chad-cros-tamu/AutomatedSafetySystem/README

The hardware folder folder is for the hardware designs of the main controller board, the light curtain and the proximity sensor
The firmware folder is for the code that runs the MCU.
