chad-cros-tamu/AutomatedSafetySystem/webpage/README.md

# Team-11-Senior-Design
ECEN 403-Team 11 Senior Design Repository (Spring 2019)
