chad-cros-tamu/AutomatedSafetySystem/Hardware/Light Curtain Board Design/README

Design and validation of light curtain sensor
