chad-cros-tamu/AutomatedSafetySystem/Hardware/Light Curtain Board Design/reference voltage.xlsx

Reference Voltage | 0.7
Distance (in) | Voltage
10 | 4.9
20 | 4.9
30 | 4.9
40 | 4.9
50 | 4.9
60 | 4.9
70 | 4.4
80 | 2.5
Reference Voltage | 1
Distance (in) | Voltage
10 | 4.8
20 | 4.8
30 | 4.8
40 | 1.8
50 | 1
60 | 0.6
70 | 0.3
80 | 0.2
Reference Voltage | 1.5
Distance (in) | Voltage
10 | 4.9
20 | 4.9
30 | 0.2
40 | 0.2
50 | 0.2
60 | 0.2
70 | 0.2
80 | 0.2
Reference Voltage | 0.5
Distance (in) | Voltage
10 | 4.9
20 | 4.9
30 | 4.9
40 | 4.9
50 | 4.9
60 | 4.9
70 | 4.9
80 | 4.9
120 | 4.9
