chad-cros-tamu/AutomatedSafetySystem/Jaime_Weekly_Updates.md

# Week of 09/02
## Accomplished this week:
- Retested the code to make sure that it is functioning
- Found that text messaging part was not working as intended

## Objectives for next week:
- Troubleshoot text messaging notification part of code as it only sends message periodically, not event driven
- Work on first presentation update with the rest of the team

# Week of 09/09
## Accomplished this week:
- Still working on fixing the text messaging issue

## Objectives for next week:
- Fix the text messaging issue 100%
- Have website running from a raspberry pi
