chad-cros-tamu/AutomatedSafetySystem/Hardware/Light Curtain Board Design/logic.asc

A1: or
D1: LED
R1: res; 100
ref: voltage; .800
Sensors: voltage; 1.5
U1: LT1017
U2: LT1017
U3: LT1017
U4: LT1017
U5: LT1017
VCC: voltage; 5
Named nets: 0, V_out, Comp_out, ref
;op Sensors 0.3 4 .1
.dc Sensors 0.3 3.6 .01
