chad-cros-tamu/AutomatedSafetySystem/Hardware/Beacon/Beacon.brd

## EAGLE design Hardware/Beacon/Beacon.brd (2019-11-26)

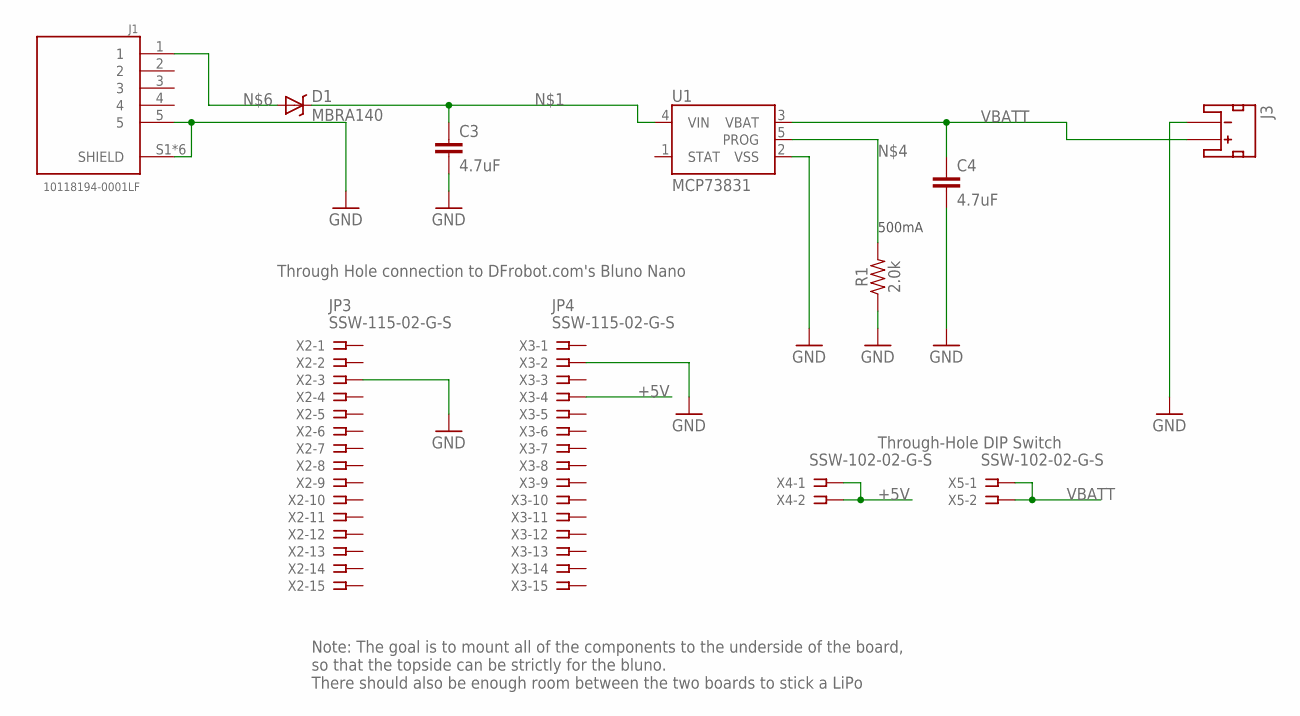
[picture p1: schematic Beacon.sch]

Parts:
C3, C4: 4.7uF; 0603
D1: MBRA140; SMA-DIODE
J1: 10118194-0001LF; AMPHENOL_10118194-0001LF
J3: JST_2MM_MALE; JST-2-SMD
R1: 2.0k; 0603
U1: MCP73831; SOT23-5
X2, X3: SSW-115-02-G-S
X4, X5: SSW-102-02-G-S

Connections:
+5V: X3.4, X4.1, X4.2
GND: C3.2, C4.2, J1.5, J1.S1 (SHIELD), J1.S2 (SHIELD), J1.S3 (SHIELD), J1.S4 (SHIELD), J1.S5 (SHIELD), J1.S6 (SHIELD), J3.1 (-), R1.1, U1.2 (VSS), X2.3, X3.2
unnamed: C3.1, D1.C, U1.4 (VIN)
unnamed: R1.2, U1.5 (PROG)
unnamed: D1.A, J1.1
VBATT: C4.1, J3.2 (+), U1.3 (VBAT), X5.1, X5.2

Notes on the sheet:
500mA
JP3
JP4
Through-Hole DIP Switch
Through Hole connection to DFrobot.com's Bluno Nano
Note: The goal is to mount all of the components to the underside of the board, so that the topside can be strictly for the bluno. There should also be enough room between the two boards to stick a LiPo

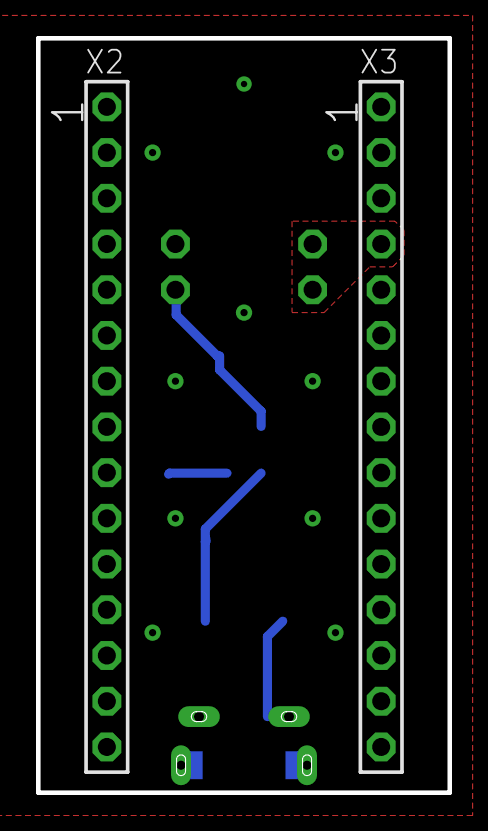
[picture p2: board Beacon.brd from above]

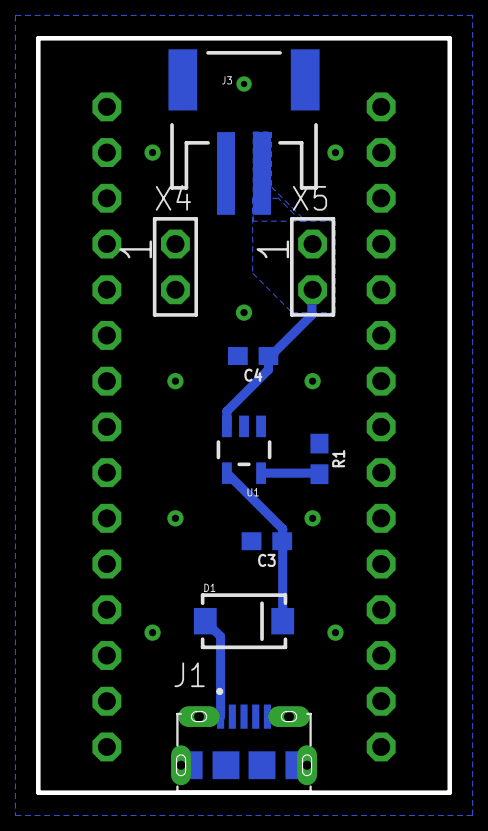
[picture p3: board Beacon.brd from below]

Board: 2 copper layers, 22.9 x 41.9 mm, 11 parts (9 on the bottom side), 6 nets.
