chad-cros-tamu/AutomatedSafetySystem/Hardware/CC3200 Breakout/Breakout.brd

## EAGLE design Hardware/CC3200 Breakout/Breakout.brd (2019-11-26)

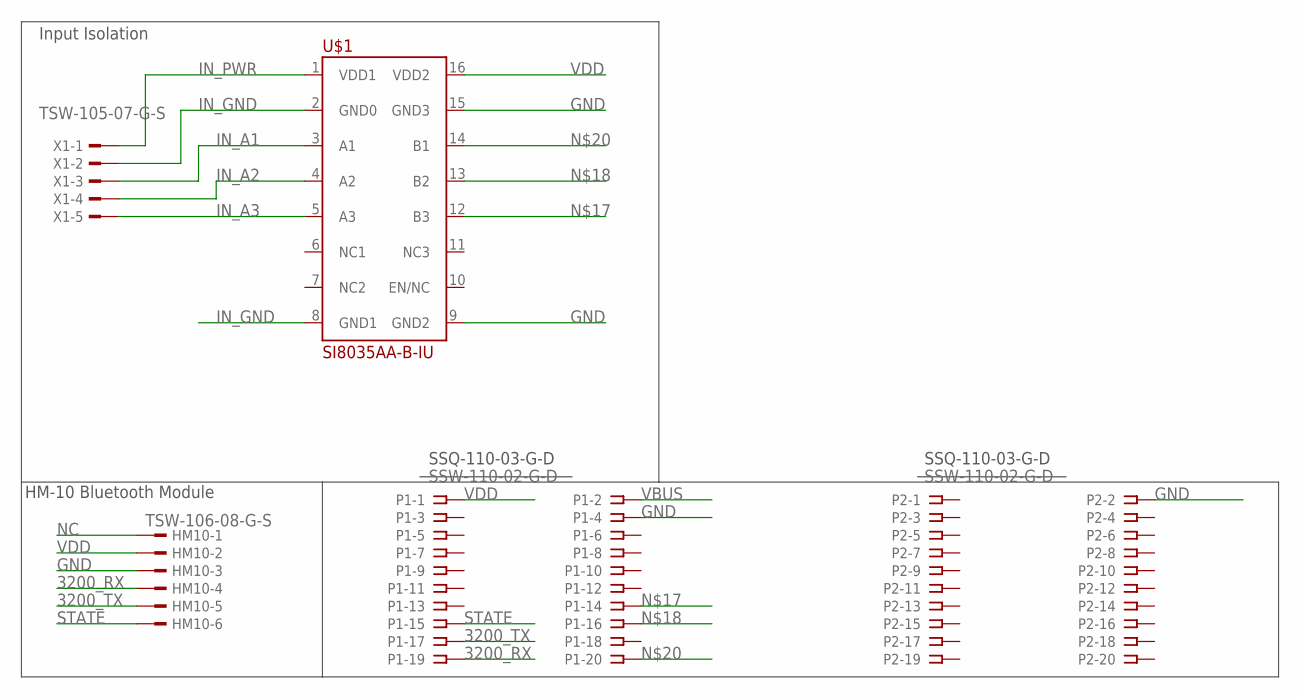
[picture p4: schematic Breakout.sch]

Parts:
HM10: TSW-106-08-G-S; TSW-106-XX-G-S
P1, P2: SSW-110-02-G-D
U$1: SI8035AA-B-IU; SOP63P602X175-16N
X1: TSW-105-07-G-S; TSW-105-XX-G-S

Connections:
3200_RX: HM10.4, P1.19
3200_TX: HM10.5, P1.17
GND: HM10.3, P1.4, P2.2, U$1.9 (GND2), U$1.15 (GND3)
IN_A1: U$1.3 (A1), X1.3
IN_A2: U$1.4 (A2), X1.4
IN_A3: U$1.5 (A3), X1.5
IN_GND: U$1.2 (GND0), U$1.8 (GND1), X1.2
IN_PWR: U$1.1 (VDD1), X1.1
unnamed: P1.14, U$1.12 (B3)
unnamed: P1.16, U$1.13 (B2)
unnamed: P1.20, U$1.14 (B1)
NC: HM10.1
STATE: HM10.6, P1.15
VBUS: P1.2
VDD: HM10.2, P1.1, U$1.16 (VDD2)

Notes on the sheet:
HM-10 Bluetooth Module
SSQ-110-03-G-D
Input Isolation

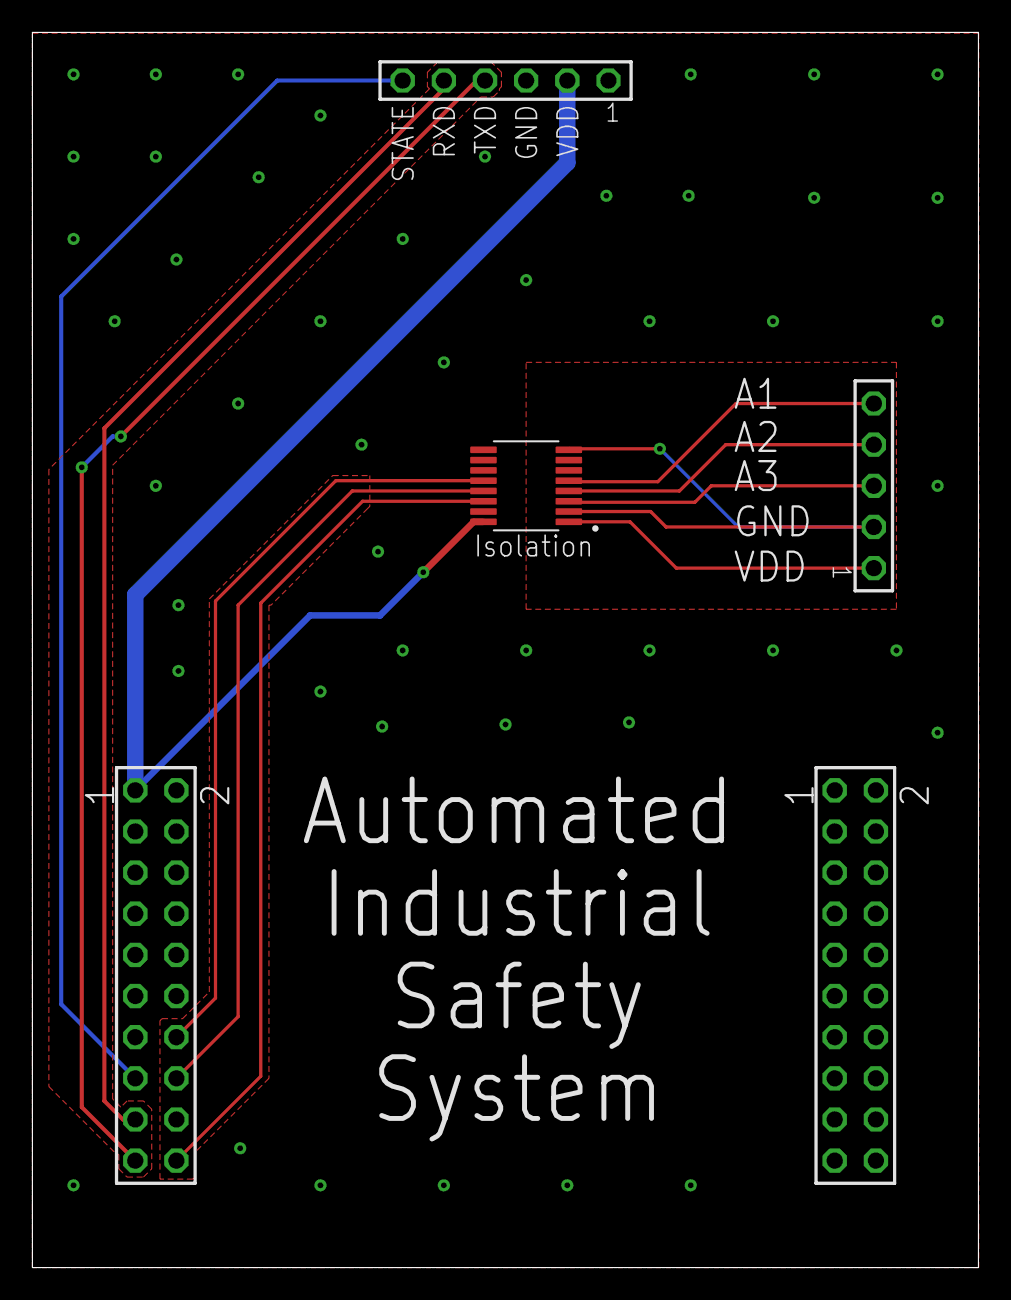
[picture p5: board Breakout.brd from above]

Board: 2 copper layers, 58.4 x 76.3 mm, 5 parts (0 on the bottom side), 13 nets.
