chad-cros-tamu/AutomatedSafetySystem/Hardware/Light Curtain Board Design/Light Curtain 5.brd

## EAGLE design Hardware/Light Curtain Board Design/Light Curtain 5.brd (2019-10-03)

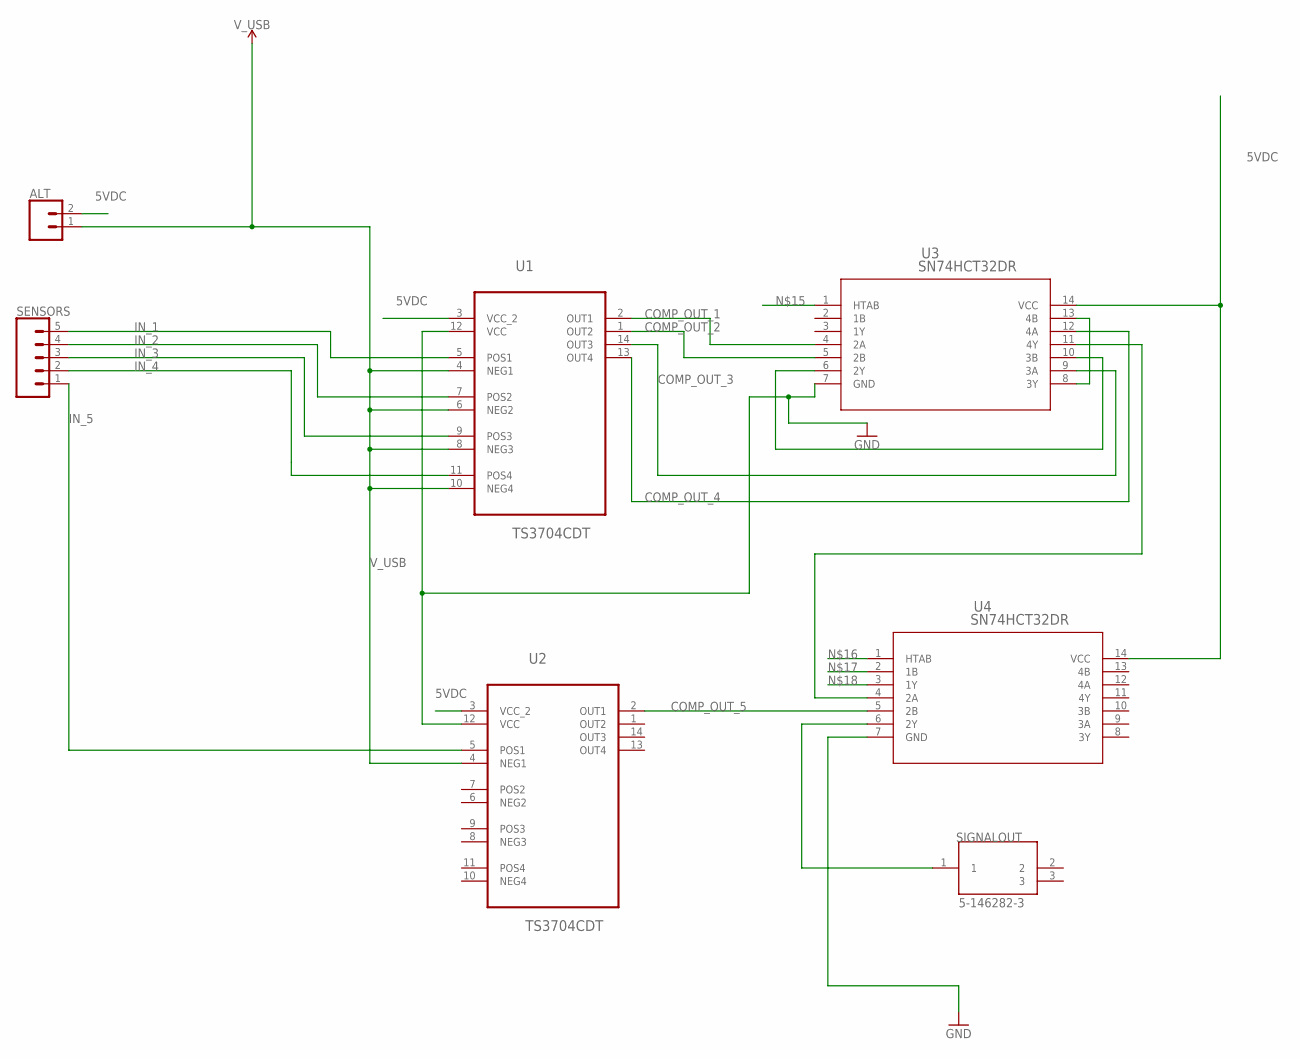
[picture p6: schematic Light Curtain 5.sch]

Parts:
ALT: CONN_02; 1X02
SENSORS: CONN_05; 1X05
SIGNALOUT: 5-146282-3; TE_5-146282-3
U1, U2: TS3704CDT; SOIC127P600X175-14N
U3, U4: SN74HCT32DR; D14

Connections:
5VDC: ALT.2, U1.3 (VCC_2), U2.3 (VCC_2), U3.14 (VCC), U4.14 (VCC)
COMP_OUT_1: U1.2 (OUT1), U3.4 (2A)
COMP_OUT_2: U1.1 (OUT2), U3.5 (2B)
COMP_OUT_3: U1.14 (OUT3), U3.9 (3A)
COMP_OUT_4: U1.13 (OUT4), U3.12 (4A)
COMP_OUT_5: U2.2 (OUT1), U4.5 (2B)
GND: U1.12 (VCC), U2.12 (VCC), U3.7 (GND), U4.7 (GND)
IN_1: SENSORS.5, U1.5 (POS1)
IN_2: SENSORS.4, U1.7 (POS2)
IN_3: SENSORS.3, U1.9 (POS3)
IN_4: SENSORS.2, U1.11 (POS4)
IN_5: SENSORS.1, U2.5 (POS1)
unnamed: U3.6 (2Y), U3.10 (3B)
unnamed: U3.8 (3Y), U3.13 (4B)
unnamed: U3.11 (4Y), U4.4 (2A)
unnamed: SIGNALOUT.1, U4.6 (2Y)
V_USB: ALT.1, U1.4 (NEG1), U1.6 (NEG2), U1.8 (NEG3), U1.10 (NEG4), U2.4 (NEG1)

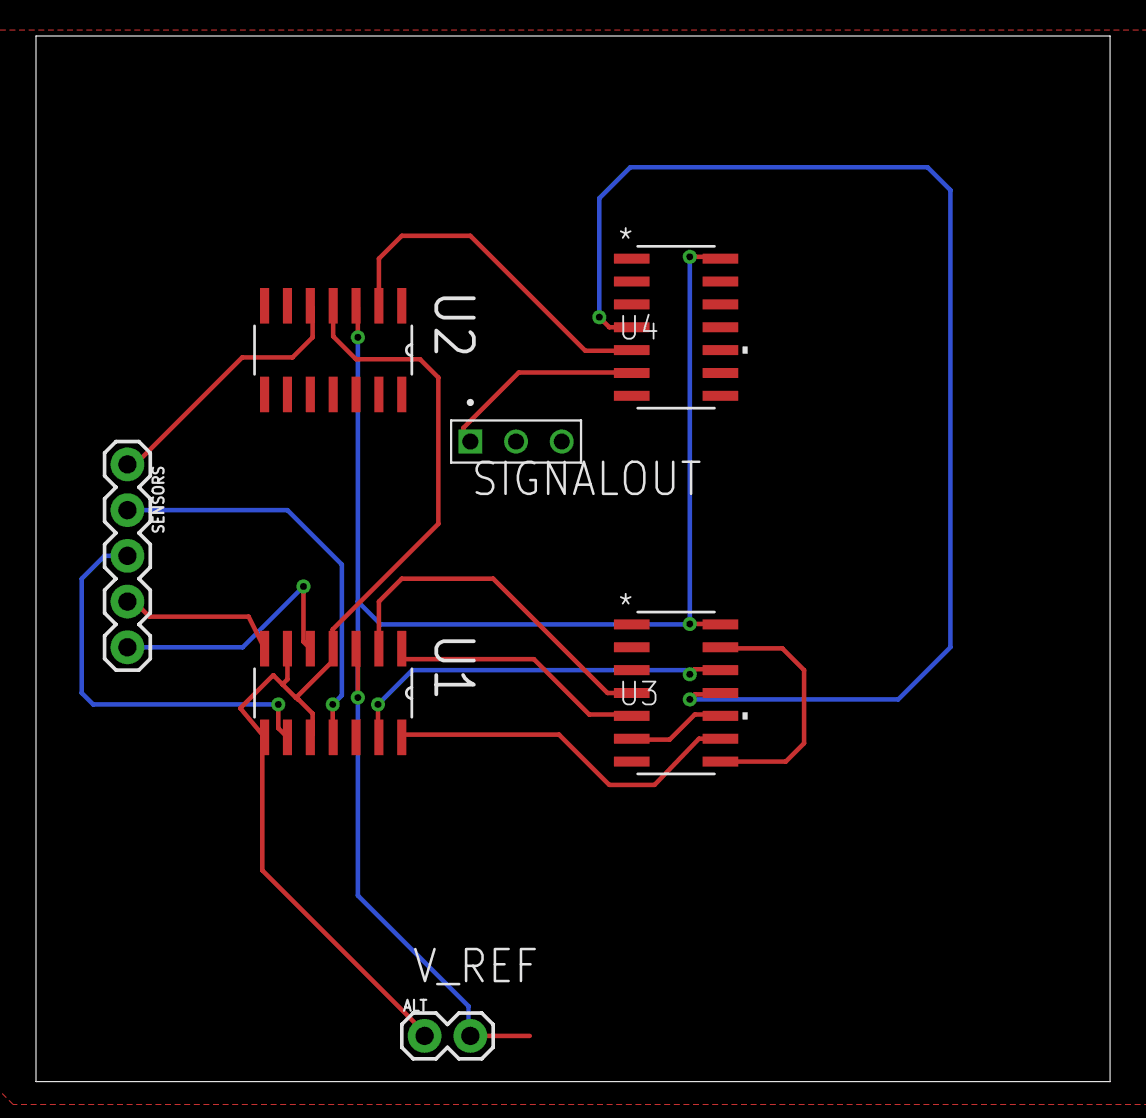
[picture p7: board Light Curtain 5.brd from above]

Board: 2 copper layers, 59.7 x 58.1 mm, 7 parts (0 on the bottom side), 17 nets.
