chad-cros-tamu/AutomatedSafetySystem/testp/README.md

# Team-11-Senior-Design
ECEN 403-Team 11 Senior Design Repository (Spring 2019)
