chad-cros-tamu/AutomatedSafetySystem/Hardware/Light Curtain Board Design/Contunity and Test cases.xlsx

Sheet: Continuity
Continuity
In A | In B | Signal | Pass | Notes
VCC-Source | VCC | 5V source | y
Ref-Rource | Ref-usb | Reference Voltage | y
GND Source | GND | Ground | y
S1 | U2-5 | Sensor input | y
S2 | U1-11 | Sensor input | y
S3 | U1-9 | Sensor input | y
S4 | U1-7 | Sensor input | y
S5 | U1-5 | Sensor input | y
Ref-usb | U2-4 | Ref Voltage | y
Ref-usb | U1-10 | Ref Voltage | y
Ref-usb | U1-8 | Ref Voltage | y
Ref-usb | U1-6 | Ref Voltage | y
Ref-usb | U1-4 | Ref Voltage | y
VCC | U2-3 | VCC source | y
VCC | U1-3 | VCC source | y
VCC | U3-14 | VCC source | y
VCC | U4-14 | VCC source | y
GND | U2-12 | GND source | y
GND | U1-12 | GND source | y
GND | U3-7 | GND source | y
GND | U4-7 | GND source | y
U1-2 | U3-4 | Inp 1 OR 1 | y
U1-1 | U3-5 | Inp 2 Or 1 | y
U3-6 | U3-10 | Inp 1 OR 2 | y
U1-14 | U3-9 | Inp 2 OR 2 | y
U3-8 | U3-13 | Inp 1 OR 3 | y
U1-13 | U3-12 | Inp 2 OR 3 | y
U3-11 | U4-4 | Inp 1 OR 4 | y
U2-2 | U4-5 | Inp 2 OR 4 | y
U4-6 | SIG OUT 1 | Logic output | y

Sheet: Test
Logic Test Comp |  |  |  |  |  |  |  | Loigc Test OR
Gate | Inp 1 | V | Inp2 | V2 | Expected | Actual | Test | Gate | Inp 1 | V | Inp2 | V2 | Expected | Actual | Test
Comp 1 | Low | 8mV | Ref | 1 | Low | 0 | y | OR1 | Comp 1 - Low | 2mV | Comp 2 - Low | 2mV | Low | 3.3mV | y
Comp 1 | High | 5 | Ref | 1 | High | 4.9 | y | OR1 | Comp 1 - High | 5V | Comp 2 - Low | 2mV | High | 5V | y
Comp 2 | Low | 0 | Ref | 1 | Low | 13mV | y | OR1 | Comp 1 - Low | 2mV | Comp 2 - High | 5V | High | 5V | y
Comp 2 | High | 5 | Ref | 1 | High | 4.9 | y | OR1 | Comp 1 - High | 5V | Comp 2 - High | 5V | High | 5V | y
Comp 3 | Low | 0 | Ref | 1 | Low | 5.2mV | y | OR2 | Comp 3 - Low | 3mV | OR1 - Low | 3mV | Low | 6mV | y
Comp 3 | High | 5 | Ref | 1 | High | 5 | y | OR2 | Comp 3 - High | 5V | OR1 - Low | 4mV | High | 5V | y
Comp 4 | Low | 0 | Ref | 1 | Low | 1mV | y | OR2 | Comp 3 - Low | 2mV | OR1 - High | 5V | High | 5V | y
Comp 4 | High | 5 | Ref | 1 | High | 5 | y | OR2 | Comp 3 - High | 5V | OR1 - High | 5V | High | 5V | y
Comp 5 | Low | 0 | Ref | 1 | Low | 8mV | y | OR3 | Comp 4 - Low | 4mV | OR2 - Low | 4mV | Low | 5mV | y
Comp 5 | High | 5 | Ref | 1 | High | 5 | y | OR3 | Comp 4 - High | 5V | OR2 - Low | 2mV | High | 5V | y
 |  |  |  |  |  |  |  | OR3 | Comp 4 - Low | 7mV | OR2 - High | 5V | High | 5V | y
 |  |  |  |  |  |  |  | OR3 | Comp 4 - High | 5V | OR2 - High | 5V | High | 5V | y
 |  |  |  |  |  |  |  | OR4 | Comp 5 - Low | 7mV | OR3 - Low | 3mV | Low | 3mV | y
 |  |  |  |  |  |  |  | OR4 | Comp 5 - High | 5V | OR3 - Low | 2mV | High | 5V | y
 |  |  |  |  |  |  |  | OR4 | Comp 5 - Low | 4mV | OR3 - High | 5V | High | 5V | y
 |  |  |  |  |  |  |  | OR4 | Comp 5 - High | 5V | OR3 - High | 5V | High | 5V | y
 | Digital Logic |  |  | Web Indicator
 | Light C. | EStop | Door Swtich | Light C. Web | Estop Web | Door Swtich Web
Trigger | 0 | 0 | 0 | n | n | n
 | 0 | 0 | 1 | n | n | y
 | 0 | 1 | 0 | n | y | n
 | 0 | 1 | 1 | n | y | y
 | 1 | 0 | 0 | y | n | n
 | 1 | 0 | 1 | y | n | y
 | 1 | 1 | 0 | y | y | n
 | 1 | 1 | 1 | y | y | y
Test | Light Curtain | E- Stop | Door Interlock
Time to indicator on (S) | 3.8 | 4.85 | 2.97
Time to indicator off (S) | 5.51 | 8.65 | 4.19
