chad-cros-tamu/AutomatedSafetySystem/(commit log)

2019-09-05 Added Schematic and Layout files to repository
    [Controller.brd, Controller.sch]
2019-09-05 Updated git to contain current working files
2019-10-03 Removed outdated hardware
    [Controller.brd, Controller.sch]
2019-10-03 Updated Hardware
    Added PCB layouts + schematics to their appropriate folders
    [Breakout.brd, Breakout.sch, Light Curtain 5.brd, Light Curtain 5.sch]
2019-10-03 Create README
    Added a description of the problems found with the PCB
2019-11-26 Updated the breakout schematics
    [Breakout.brd, Breakout.sch]
2019-11-26 Added WIFI Controller Firmware
    File is responsible for interfacing the Bluetooth module, the Hardware sensors, and the Webpage
2019-11-26 Added schematic + layout for the bluetooth beacons
    [Beacon.brd, Beacon.sch]
